RhysLloyd99/InfraredCircuit/Infrared.asc

CI: cap; 1µ
CO: cap; 10n
D2: diode
DO: diode
Phototransistor: current; PULSE(0 100u 0 0 0 50u 0.0022); AC 100u
Q1: npn; BC547B
R1: res; 2k
R2: res; 3k
R3: res; 10k
RB1: res; 200k
RB2: res; 39k
RB3: res; 10k
Rc: res; 5k
RI: res; 10k
RL: res; 1Meg
RO: res; 220k
V1: voltage; SINE(0 0.05 100)
V3: voltage; 5
Vbias: voltage; 5
Vcc: voltage; 5
Named nets: 0, Vin, Vout
.tran 0.02
.ac dec 100 1 100kHz
.op
